No-Chicken/OV-Watch/3D Modle/按键零件.STL

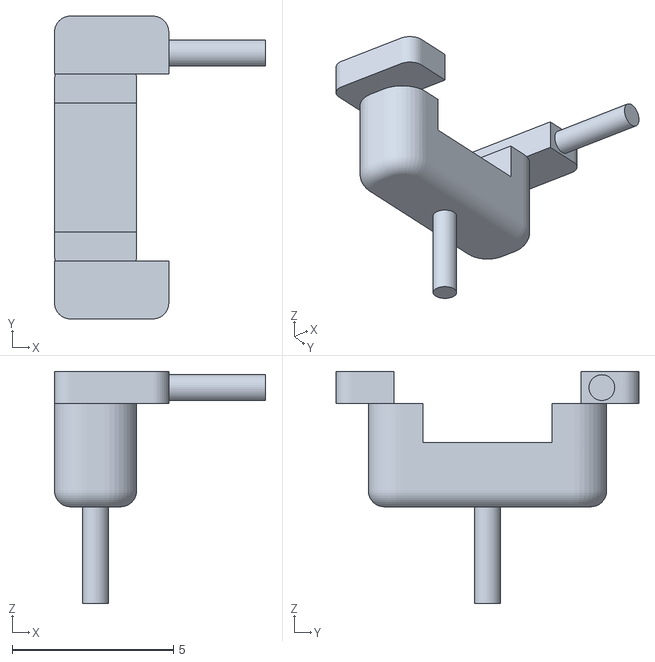
[picture p20: CAD file, 2023-07-12]
3D Modle/按键零件.STL
6.55 x 9.40 x 7.20
