No-Chicken/OV-Watch/3D Modle/后壳零件.STL

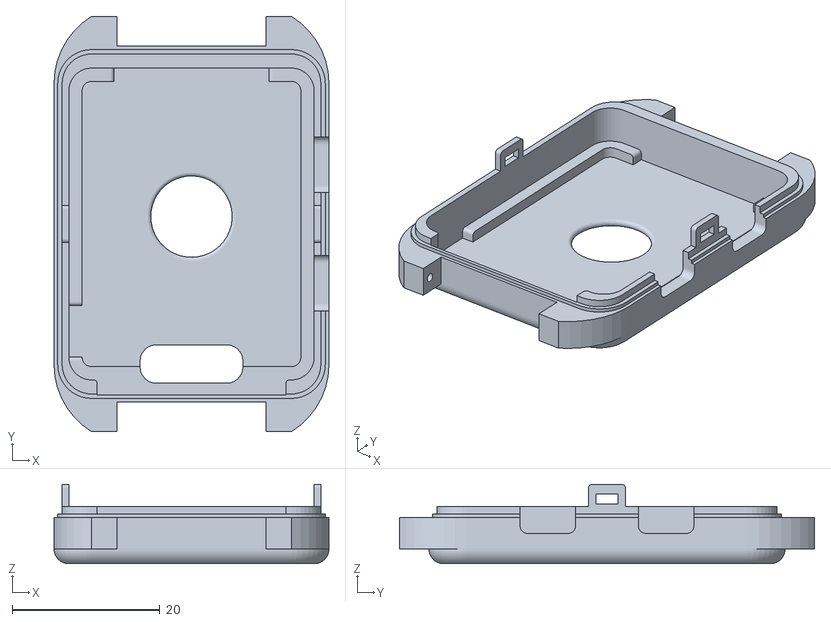
[picture p21: CAD file, 2023-07-12]
3D Modle/后壳零件.STL
37.2 x 56.2 x 10.8
