No-Chicken/OV-Watch/3D Modle/前壳零件.STL

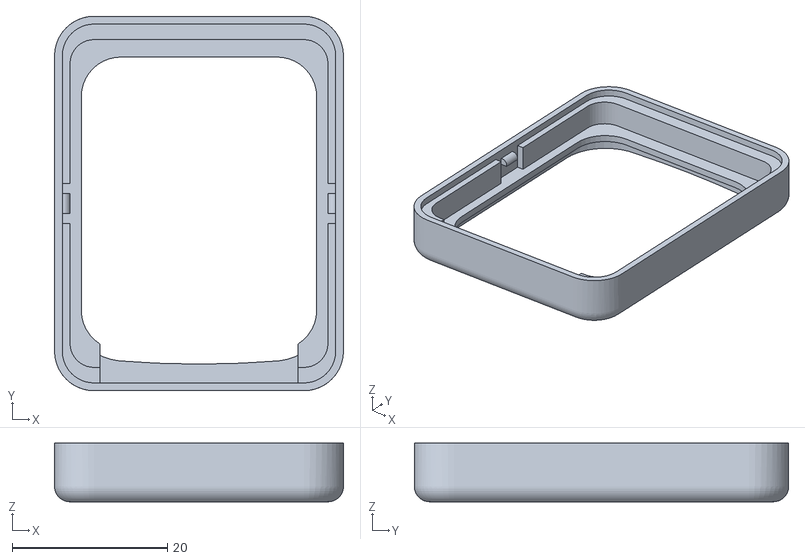
[picture p22: CAD file, 2023-07-12]
3D Modle/前壳零件.STL
37.2 x 48.2 x 7.55
