No-Chicken/OV-Watch/(threads)

Thread 5 (2024-06-12):

HelloGitHub 徽章计划

521xueweihan, 2024-06-12:
🎉 恭喜！您的[项目](https://hellogithub.com/repository/396acae90639497d82101e149577db8c)已被 HelloGitHub 社区收录和推荐，现邀请您加入 HelloGitHub 徽章计划。加入后，您将获得以下特权：

- 社区认可: 徽章代表你的项目已通过 HelloGitHub 社区的严格筛选，并获得推荐。
- 提高曝光: 佩戴徽章后，你的项目将获得更多推荐流量，吸引更多用户和贡献者。
- 增强互动: 用户可通过徽章快速了解项目，并与之互动（点赞、评论、收藏）。
- 收集反馈: 获取广大用户的真实反馈，持续优化你的项目。
- 特殊标识: 认证后，你的评论将有显著标识，并获得置顶优先权。

📌 [立即点击](https://hellogithub.com/repository/396acae90639497d82101e149577db8c/embed) 完成徽章佩戴，加入 HelloGitHub 徽章计划，让你的开源项目绽放更耀眼的光彩。

---

**HelloGitHub**，一个专注于发现、分享、推广开源项目的社区。自 2016 年创立以来，从每月一更的月刊发展到今天，已经成为一个拥有超过 **1 万** 用户的充满活力的开源社区。我们的足迹遍布多个内容平台，并获得了全网 **50 万** 粉丝的信赖与支持。

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

Closed 2025-01-04.

Thread 7 (2024-10-02):

IIC模块SDA引脚模式

JeffChong0125, 2024-10-02:
大佬，你这个IIC模块的SDA引脚的模式感觉还是配置为开漏输出模式好点，我看你代码这个模式切来切去的，不知道是不是我的理解不够深，正常应该是SCL和SDA直接配置为开漏输出，然后通过给0拉低，给1释放控制权，引脚直接由上拉电阻拉至高阻态

No-Chicken, 2025-01-04:
BSP驱动层可以不管了，能用就行

No-Chicken, 2025-01-04:
BSP驱动层可以不管了，能用就行

Closed 2025-01-04.

Thread 9 (2025-01-02):

Bug in DataSave.c

Lingxicheng, 2025-01-02:
如果使用这样的代码调用
```
uint8_t data[10] = {1,2,3};
EEPROM_Init();
SettingSave(data, 0x0, 10);
SettingGet(data, 0x0, 10);

```
data前两个值会发生改变，变成 0x55, 0xAA，最好将函数修改成这样
```
//to Save the settings
uint8_t SettingSave(uint8_t *buf, uint8_t addr, uint8_t lenth)
{
	if(addr > 1 &&!EEPROM_Check())
	{
		delay_ms(10);
		BL24C02_Write(addr,lenth,buf);
		return 0;
	}
	return 1;
}

//to Get the settings
uint8_t SettingGet(uint8_t *buf, uint8_t addr, uint8_t lenth)
{
	if(addr > 1 && !EEPROM_Check())
	{
		delay_ms(10);
		BL24C02_Read(addr,lenth,buf);
		return 0;
	}
	return 1;
}
```

No-Chicken, 2025-01-04:
是的，为了防止错误使用应该改成这样，可以pull request一下

Lingxicheng, 2025-01-05:
pull request 了,git 好复杂😉
