No-Chicken/OV-Watch/Hardware/SCH_Back_2024-05-26.pdf

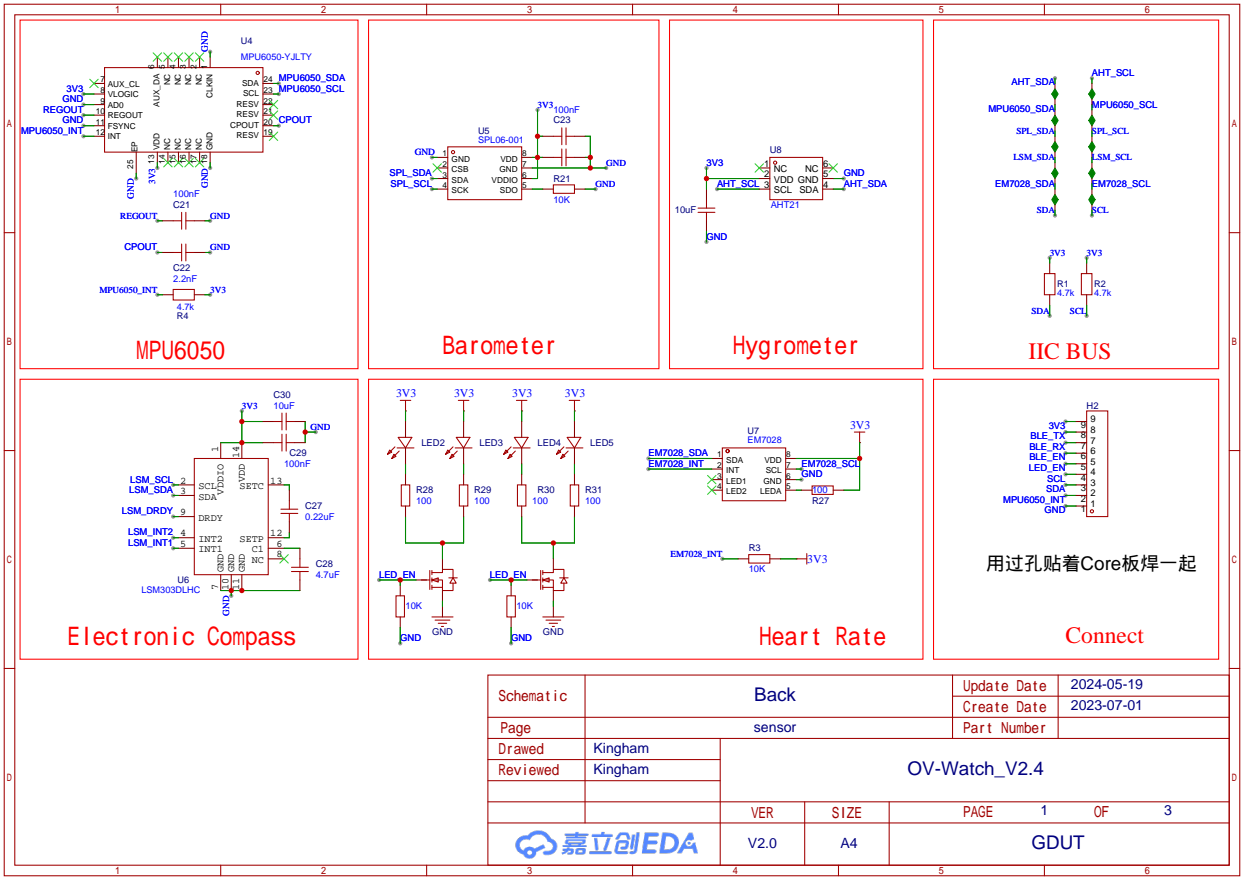
[picture p23: page 1]

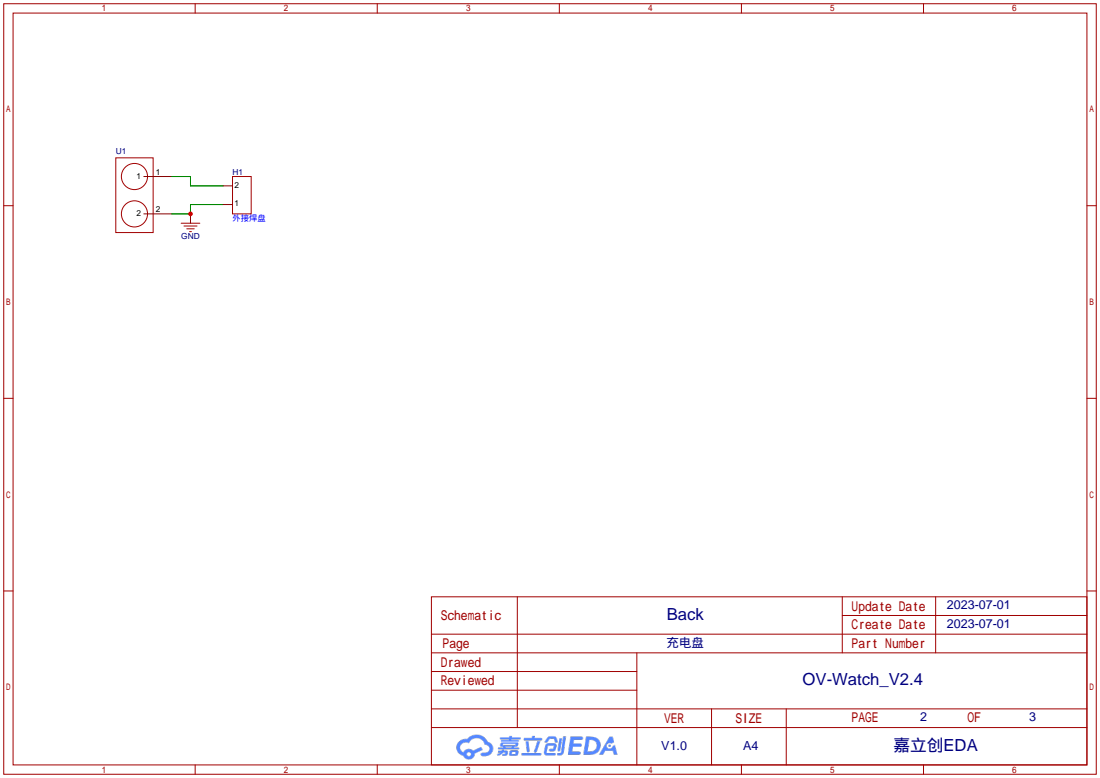
[picture p24: page 2]

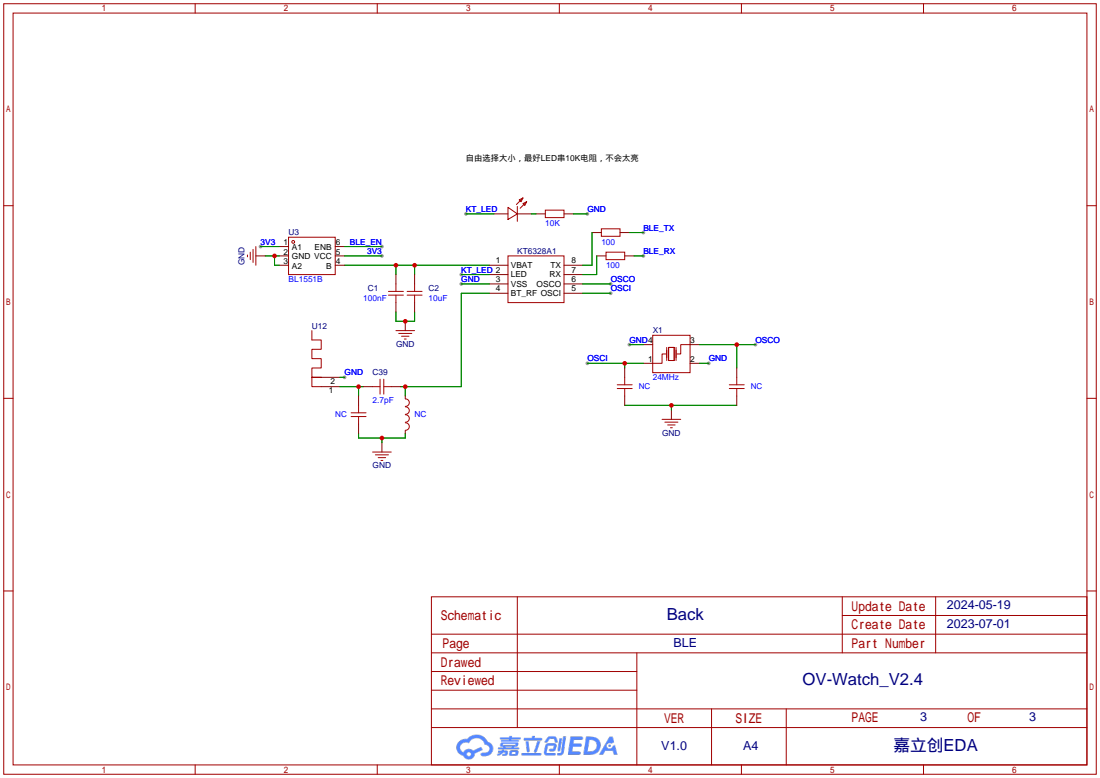
[picture p25: page 3]
