No-Chicken/OV-Watch/Hardware/SCH_Core_2024-05-26.pdf

# PA0 10 PA1 11 PA2 12 PA3 13 PA4 14 PA5 15 PA6 16 PA7 17

# PB1 19 PB2 20 PB3 39 PB4 40 PB5 41 PB6 42 PB7 43

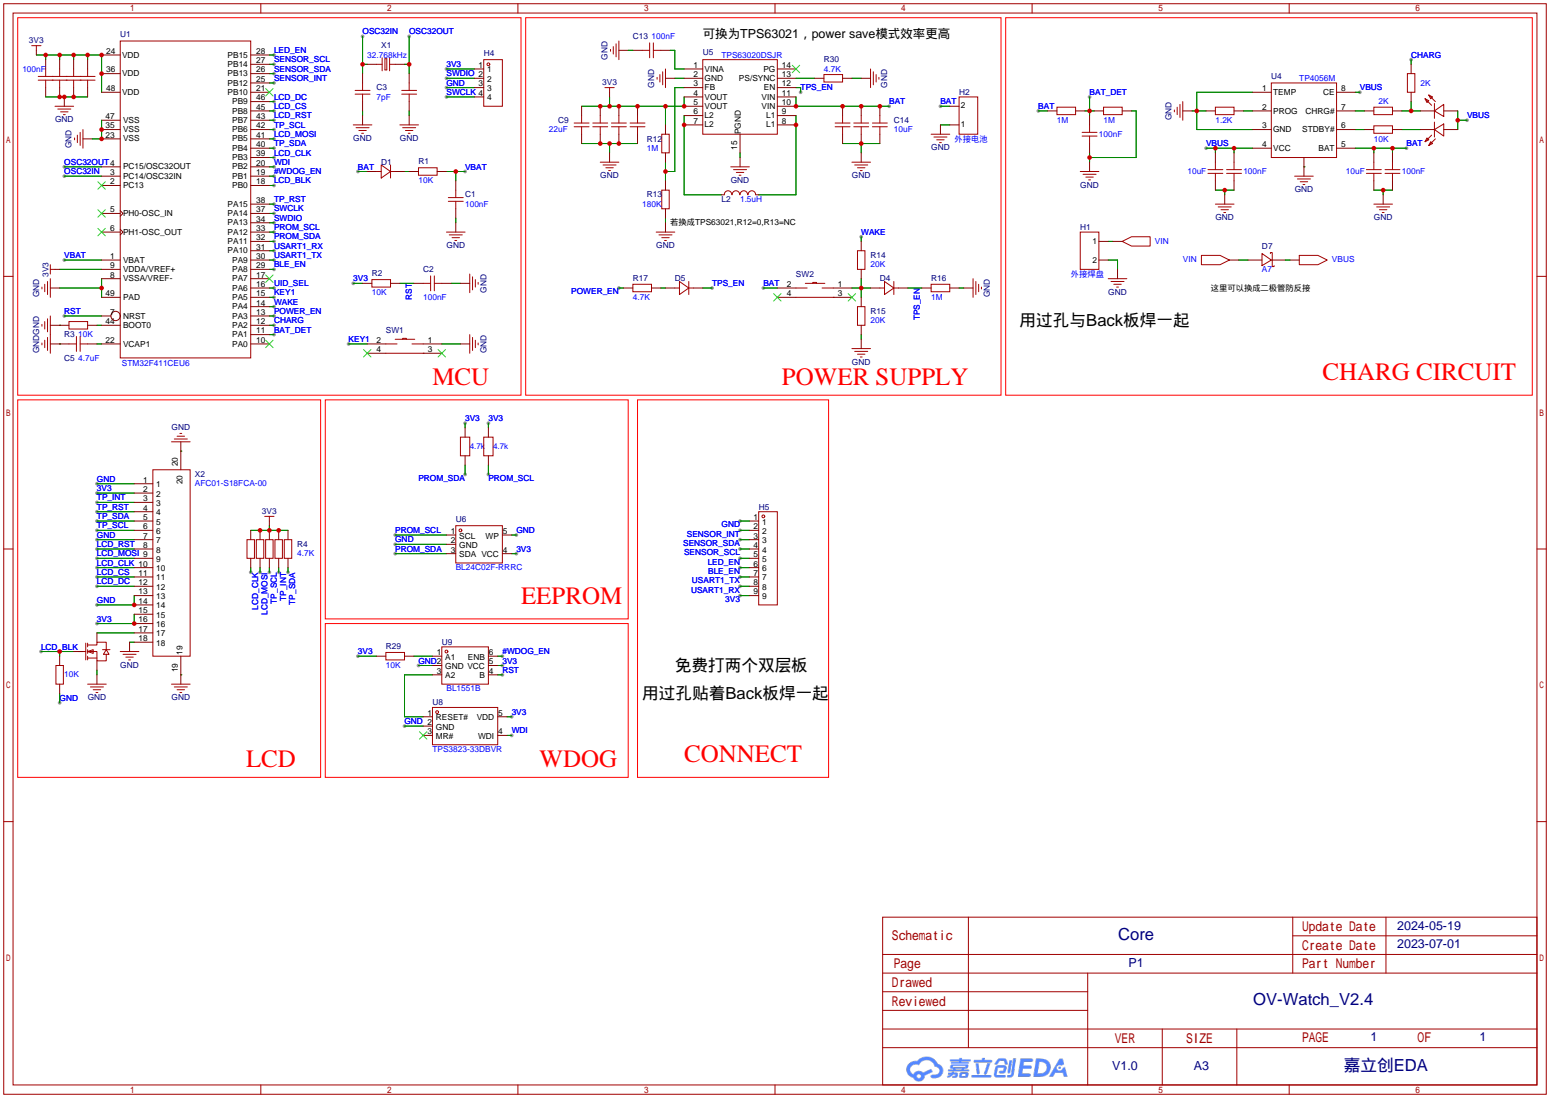
[picture p26: page 1]

VIN 10 VIN 11 EN 12 PS/SYNC 13 PG 14 PGND 15
