No-Chicken/OV-Watch/(list of files, drawings)

Other design files:
Hardware/OV-Watch_V2.4_LCProject_2024-05-25.epro
