No-Chicken/OV-Watch/Software/OV_Watch/OV_Watch.ioc

Mcu.UserName=STM32F411CEUx
PA1.Signal=ADCx_IN1
PA10.Signal=USART1_RX
PA13.Signal=SYS_JTMS-SWDIO
PA14.Signal=SYS_JTCK-SWCLK
PA9.Signal=USART1_TX
PB0.Signal=S_TIM3_CH3
PB3.Signal=SPI1_SCK
PB5.Signal=SPI1_MOSI
PC14-OSC32_IN.Signal=RCC_OSC32_IN
PC15-OSC32_OUT.Signal=RCC_OSC32_OUT
