No-Chicken/OV-Watch/Software/OV_Watch/BSP/KT6328/KT6328.h

#ifndef __KT6328_H__
#define __KT6328_H__

#ifdef __cplusplus
extern "C" {
#endif

#include "main.h"

void KT6328_GPIO_Init(void);
void KT6328_Enable(void);
void KT6328_Disable(void);


#ifdef __cplusplus
}
#endif
#endif
