No-Chicken/OV-Watch/Software/OV_Watch/User/Tasks/Src/user_MessageSendTask.c

/* Private includes -----------------------------------------------------------*/
//includes
#include "string.h"
#include "stdio.h"

#include "main.h"
#include "stm32f4xx_it.h"
#include "rtc.h"

#include "user_TasksInit.h"
#include "user_MessageSendTask.h"

#include "ui.h"
#include "ui_EnvPage.h"
#include "ui_HRPage.h"
#include "ui_SPO2Page.h"
#include "ui_HomePage.h"
#include "ui_DateTimeSetPage.h"

#include "HWDataAccess.h"
#include "version.h"

/* Private typedef -----------------------------------------------------------*/

/* Private define ------------------------------------------------------------*/

/* Private variables ---------------------------------------------------------*/
struct
{
	RTC_DateTypeDef nowdate;
	RTC_TimeTypeDef nowtime;
	int8_t humi;
	int8_t temp;
	uint8_t HR;
	uint8_t SPO2;
	uint16_t stepNum;
}BLEMessage;

struct
{
	RTC_DateTypeDef nowdate;
	RTC_TimeTypeDef nowtime;
}TimeSetMessage;

/* Private function prototypes -----------------------------------------------*/

void StrCMD_Get(uint8_t * str,uint8_t * cmd)
{
	uint8_t i=0;
  while(str[i]!='=')
  {
      cmd[i] = str[i];
      i++;
  }
}

//set time//OV+ST=20230629125555
uint8_t TimeFormat_Get(uint8_t * str)
{
	TimeSetMessage.nowdate.Year = (str[8]-'0')*10+str[9]-'0';
	TimeSetMessage.nowdate.Month = (str[10]-'0')*10+str[11]-'0';
	TimeSetMessage.nowdate.Date = (str[12]-'0')*10+str[13]-'0';
	TimeSetMessage.nowtime.Hours = (str[14]-'0')*10+str[15]-'0';
	TimeSetMessage.nowtime.Minutes = (str[16]-'0')*10+str[17]-'0';
	TimeSetMessage.nowtime.Seconds = (str[18]-'0')*10+str[19]-'0';
	if(TimeSetMessage.nowdate.Year>0 && TimeSetMessage.nowdate.Year<99
		&& TimeSetMessage.nowdate.Month>0 && TimeSetMessage.nowdate.Month<=12
		&& TimeSetMessage.nowdate.Date>0 && TimeSetMessage.nowdate.Date<=31
		&& TimeSetMessage.nowtime.Hours>=0 && TimeSetMessage.nowtime.Hours<=23
		&& TimeSetMessage.nowtime.Minutes>=0 && TimeSetMessage.nowtime.Minutes<=59
		&& TimeSetMessage.nowtime.Seconds>=0 && TimeSetMessage.nowtime.Seconds<=59)
	{
		RTC_SetDate(TimeSetMessage.nowdate.Year, TimeSetMessage.nowdate.Month,TimeSetMessage.nowdate.Date);
		RTC_SetTime(TimeSetMessage.nowtime.Hours,TimeSetMessage.nowtime.Minutes,TimeSetMessage.nowtime.Seconds);
		printf("TIMESETOK\r\n");
	}

}

/**
  * @brief  send the message via BLE, use uart
  * @param  argument: Not used
  * @retval None
  */
void MessageSendTask(void *argument)
{
	while(1)
	{
		uint32_t hardint_flags = osEventFlagsWait(HardIntEventHandle, HARDINT_EVENT_UART, osFlagsWaitAny, osWaitForever);
		if((hardint_flags & HARDINT_EVENT_UART) != 0U)
		{
			uint8_t IdleBreakstr = 0;
			osMessageQueuePut(IdleBreak_MessageQueue,&IdleBreakstr,NULL,1);
			printf("RecStr:%s\r\n",HardInt_receive_str);
			if(!strcmp(HardInt_receive_str,"OV"))
			{
				printf("OK\r\n");
			}
			else if(!strcmp(HardInt_receive_str,"OV+VERSION"))
			{
				printf("VERSION=V%d.%d.%d\r\n", VERSION_MAJOR, VERSION_MINOR, VERSION_PATCH);
			}
			else if(!strcmp(HardInt_receive_str,"OV+SEND"))
			{
				HAL_RTC_GetTime(&hrtc,&(BLEMessage.nowtime),RTC_FORMAT_BIN);
				HAL_RTC_GetDate(&hrtc,&BLEMessage.nowdate,RTC_FORMAT_BIN);
				BLEMessage.humi = HWInterface.AHT21.humidity;
				BLEMessage.temp = HWInterface.AHT21.temperature;
				BLEMessage.HR = HWInterface.HR_meter.HrRate;
				BLEMessage.SPO2 = HWInterface.HR_meter.SPO2;
				BLEMessage.stepNum = HWInterface.IMU.Steps;

				printf("data:%2d-%02d\r\n",BLEMessage.nowdate.Month,BLEMessage.nowdate.Date);
				printf("time:%02d:%02d:%02d\r\n",BLEMessage.nowtime.Hours,BLEMessage.nowtime.Minutes,BLEMessage.nowtime.Seconds);
				printf("humidity:%d%%\r\n",BLEMessage.humi);
				printf("temperature:%d\r\n",BLEMessage.temp);
				printf("Heart Rate:%d%%\r\n",BLEMessage.HR);
				printf("SPO2:%d%%\r\n",BLEMessage.SPO2);
				printf("Step today:%d\r\n",BLEMessage.stepNum);
			}
			//set time//OV+ST=20230629125555
			else if(strlen(HardInt_receive_str)==20)
			{
				uint8_t cmd[10];
				memset(cmd,0,sizeof(cmd));
				StrCMD_Get(HardInt_receive_str,cmd);
				if(ui_APPSy_EN && !strcmp(cmd,"OV+ST"))
				{
					TimeFormat_Get(HardInt_receive_str);
				}
			}
			memset(HardInt_receive_str,0,sizeof(HardInt_receive_str));
		}
	}
}
