No-Chicken/OV-Watch/Software/OV_Watch/Core/Src/rtc.c

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
/* Includes ------------------------------------------------------------------*/
#include "rtc.h"

RTC_HandleTypeDef hrtc;

/* RTC init function */
void MX_RTC_Init(void)
{

  RTC_TimeTypeDef sTime = {0};
  RTC_DateTypeDef sDate = {0};

  /** Initialize RTC Only
  */
  hrtc.Instance = RTC;
  hrtc.Init.HourFormat = RTC_HOURFORMAT_24;
  hrtc.Init.AsynchPrediv = 127;
  hrtc.Init.SynchPrediv = 255;
  hrtc.Init.OutPut = RTC_OUTPUT_DISABLE;
  hrtc.Init.OutPutPolarity = RTC_OUTPUT_POLARITY_HIGH;
  hrtc.Init.OutPutType = RTC_OUTPUT_TYPE_OPENDRAIN;
  if (HAL_RTC_Init(&hrtc) != HAL_OK)
  {
    Error_Handler();
  }

  /* USER CODE BEGIN Check_RTC_BKUP */
	if(HAL_RTCEx_BKUPRead(&hrtc,RTC_BKP_DR0)!=0X5050)//是否第一次配置
  {
  /* USER CODE END Check_RTC_BKUP */

  /** Initialize RTC and set the Time and Date
  */
  sTime.Hours = 0x11;
  sTime.Minutes = 0x59;
  sTime.Seconds = 0x55;
  sTime.DayLightSaving = RTC_DAYLIGHTSAVING_NONE;
  sTime.StoreOperation = RTC_STOREOPERATION_RESET;
  if (HAL_RTC_SetTime(&hrtc, &sTime, RTC_FORMAT_BCD) != HAL_OK)
  {
    Error_Handler();
  }
  sDate.WeekDay = RTC_WEEKDAY_SUNDAY;
  sDate.Month = RTC_MONTH_MAY;
  sDate.Date = 0x21;
  sDate.Year = 0x23;

  if (HAL_RTC_SetDate(&hrtc, &sDate, RTC_FORMAT_BCD) != HAL_OK)
  {
    Error_Handler();
  }

  /** Enable the WakeUp
  */
  if (HAL_RTCEx_SetWakeUpTimer_IT(&hrtc, 2000, RTC_WAKEUPCLOCK_RTCCLK_DIV16) != HAL_OK)
  {
    Error_Handler();
  }
  /* USER CODE BEGIN RTC_Init 2 */
	HAL_RTCEx_BKUPWrite(&hrtc,RTC_BKP_DR0,0X5050);//标记已经初始化过了
  }
  /* USER CODE END RTC_Init 2 */

}

void HAL_RTC_MspInit(RTC_HandleTypeDef* rtcHandle)
{

  RCC_PeriphCLKInitTypeDef PeriphClkInitStruct = {0};
  if(rtcHandle->Instance==RTC)
  {
  /** Initializes the peripherals clock
  */
    PeriphClkInitStruct.PeriphClockSelection = RCC_PERIPHCLK_RTC;
    PeriphClkInitStruct.RTCClockSelection = RCC_RTCCLKSOURCE_LSE;
    if (HAL_RCCEx_PeriphCLKConfig(&PeriphClkInitStruct) != HAL_OK)
    {
      Error_Handler();
    }

    /* RTC clock enable */
    __HAL_RCC_RTC_ENABLE();

    /* RTC interrupt Init */
    HAL_NVIC_SetPriority(RTC_WKUP_IRQn, 5, 0);
    HAL_NVIC_EnableIRQ(RTC_WKUP_IRQn);
  }
}

void HAL_RTC_MspDeInit(RTC_HandleTypeDef* rtcHandle)
{

  if(rtcHandle->Instance==RTC)
  {
    /* Peripheral clock disable */
    __HAL_RCC_RTC_DISABLE();

    /* RTC interrupt Deinit */
    HAL_NVIC_DisableIRQ(RTC_WKUP_IRQn);
  }
}

/* USER CODE BEGIN 1 */
uint8_t weekday_calculate(int y,int m,int d,int c)
{
	int w;
	if (m == 1 || m == 2)
	{y--, m += 12;}
	w = y + y / 4 + c / 4  + 26*(m + 1)/10 + d - 1 - 2 * c;
	while(w<0)
		w+=7;
	w%=7;
	w=(w==0)?7:w;
	return w;
}

void RTC_SetTime(uint8_t hours, uint8_t minutes, uint8_t seconds)
{
	RTC_TimeTypeDef time={0};//不设置为{0}时间就会离谱
	time.Hours=hours;
	time.Minutes=minutes;
	time.Seconds=seconds;
	if (HAL_RTC_SetTime(&hrtc, &time, RTC_FORMAT_BIN) != HAL_OK)
  {
    Error_Handler();
  }
}

void RTC_SetDate(uint8_t year, uint8_t month, uint8_t date)
{
	RTC_DateTypeDef setdate={0};//不设置为{0}时间就会离谱
	setdate.Date=date;
	setdate.Month=month;
	setdate.Year=year;

	//culculat the weekday
	setdate.WeekDay = weekday_calculate(year,month,date,20);

	if (HAL_RTC_SetDate(&hrtc, &setdate, RTC_FORMAT_BIN) != HAL_OK)
  {
    Error_Handler();
  }
}
/* USER CODE END 1 */
