No-Chicken/OV-Watch/Software/OV_Watch/User/Tasks/Inc/user_ScrRenewTask.h

#ifndef __USER_SCRRENEWTASK_H__
#define __USER_SCRRENEWTASK_H__

#ifdef __cplusplus
extern "C" {
#endif

#include "PageManager.h"

void ScrRenewTask(void *argument);


#ifdef __cplusplus
}
#endif

#endif
