No-Chicken/OV-Watch/Software/OV_Watch/User/Tasks/Inc/user_DataSaveTask.h

#ifndef __USER_DATASAVETASK_H__
#define __USER_DATASAVETASK_H__

#ifdef __cplusplus
extern "C" {
#endif

#include "user_TasksInit.h"


void DataSaveTask(void *argument);

	
#ifdef __cplusplus
}
#endif

#endif
