No-Chicken/OV-Watch/Software/OV_Watch/BSP/EM7028/user_Queue.h

#include <stdio.h>
#include <stdbool.h>
#include <stdlib.h>
#include "main.h"

// 定义队列结构
#define QUEUE_SIZE 7

typedef struct {
    int8_t front;
    int8_t rear;
    int8_t size;
    uint32_t data[QUEUE_SIZE];
} Queue;

void initQueue(Queue *queue);
bool isQueueEmpty(Queue *queue);
bool isQueueFull(Queue *queue);
void enqueue(Queue *queue, unsigned long item);
uint32_t dequeue(Queue *queue);
