No-Chicken/OV-Watch/(commit log)

2023-07-12 currect the iic bus
    currect the EEPROM(BL24C02)'s SDA&SCL pin in /Hardware/BL24C02/BL24C02.c
2023-07-12 Uploat V2.3
    [上壳零件.STL, 下壳零件.STL, 前壳零件.STL, 后壳零件.STL, 按键.STL, 按键零件.STL]
2023-07-12 Upload V2.3
    [上壳零件.STL, 下壳零件.STL, 前壳零件.STL, 后壳零件.STL, 按键.STL, 按键零件.STL]
2023-07-14 Change some name of thread and MQ
2023-07-14 Fix a bug in memGame
    fix a bug that popping out the replay logo when the game is not finish, that's due to the 'x' para in the 'for' loop is not initialized, the function Game_Mem_Finish() will randomly return wrong value.
2023-07-17 Set Power Save mode
    change the hardware part, tps63020 set to power save mode, the PS/SYNC set to 0
2023-07-26 ver2.3.2, fix some bugs
    function add:
    1. mpu6050 get the steps in the low power mode
    2. EEPROM save the date and system settings
    fixed bugs:
    1.randomly reset after wake up
    2.use the dmp lib, the memgame will chock
    [AHT21.c, AHT21.h, CST816.c, CST816.h]
2023-07-26 Hardware change(power save)
    Change the power part, set TPS63020 to power save mode, which means the PS/SYNC port set to 0. The efficiency is almost 90% in power save enabled mode, but almost 60% in power save disabled mode.
2023-07-28 Fix some bugs
    1. fixed the bug that the system would always be wake when charging.
    2. change the threshold in func MPU_isHorizontal
    [mpu6050.c]
2023-08-11 fixed a type erro
    [mpu6050.c]
2023-08-12 upload firmware & fix some annotation
    [mpu6050.c]
2023-08-16 fixed a bug in AHT21 reading
    [AHT21.c]
2024-03-12 fix AHT21 BSP bug
    [AHT21.c]
2024-05-26 update ver 2.4.0 , fixed the hardware BLE bug
    [OV-Watch_V2.4_LCProject_2024-05-25.epro]
2024-06-02 更新了LVGL在vscode仿真，在SDL.c中加入了键盘backspace键按键触发屏幕切换，添加了消息订阅框架：键盘回车键按下发布按键消息，UI.c中subscriber函数收到消息后，执行界面切换
2024-06-04 轻微更改代码的结构，将功能函数单独放一个工程文件夹
2024-06-05 软件修复2.4版本的功耗问题，串口在睡眠时DeInit, 让串联电阻不耗电
2024-06-05 修改串口回复的版本信息
2024-06-05 在BootLoader中加入长按KEY1关机
2024-06-05 修改按键KEY的驱动，按下按键后松开才生效
2024-06-05 APP加入长按KEY1关机功能
2024-06-05 上传V2.4.1固件
2024-06-05 修改APP开机启动信息
2024-06-05 更新2.4.1
2024-06-05 更改一些描述
2024-06-24 更换文件夹名, 以后OV-Watch的APP都没有版本号, 仅在version.h中展现
2024-06-24 1.更改代码框架, 2. 加入version.h记录信息, 3.加入中间层用于UI层访问BSP层和HAL层，暂时写了RTC
2024-06-25 加入HWDataAccess.c作为中间层, 用于UI层访问BSP层和HAL库
    这样方便移植，直接将User中的Func和GUI_App复制到vscode仿真工程中就行了。或者在仿真器中跑好了UI，也方便直接复制过去keil工程
2024-06-25 更新LVGL在Vscode的仿真工程
2024-07-01 加入PageManager, 更新新的界面管理框架
2024-07-01 新的页面管理框架同步更新到LVGL Vscode仿真
2024-07-02 使能HW_USE_HARDWARE
2024-07-28 完善最新框架
    在ui层，访问硬件通义通过HWDataAccess.c
2024-07-28 更新最新框架的LVGL Vscode仿真
2024-07-28 更新工程设置
2024-07-28 更新固件
2024-07-28 删除main.c中多余include
2024-07-29 上传说明手册链接
2024-07-31 更改IMU初始化bug
2024-10-16 上传不需要boot的hex固件
    直接在STM32 ST-LINK Utility下载即可
2025-06-02 update BLE hardware interface
    加入init 在初始化中使用这个接口而不直接使用BSP的接口
2025-10-19 FIX BUG 解决linux平台下编译 lv_sim_vscode_vin项目编译类型报错问题
2026-05-02 更改屏幕驱动
2026-05-02 优化定时器页面时基
2026-05-02 将LCD改为异步刷新，不阻塞，加快速度
2026-05-02 更新版本
2026-05-03 更新LV刷新时间
2026-05-03 更新图片
2026-05-03 更新地址
2026-05-03 更新设置
2026-05-04 更新空闲管理
2026-05-04 修复中断设置bug
2026-05-04 使用事件标志
