No-Chicken/OV-Watch/(notices)

Notices in the files:
Software/OV_Watch/Core/Src/rtc.c:
Copyright (c) 2023 STMicroelectronics.
All rights reserved.
This software is licensed under terms that can be found in the LICENSE file
Software/OV_Watch/BSP/MPU6050/eMPL/inv_mpu.c:
Copyright(C) ¹ãÖÝÊÐÐÇÒíµç×Ó¿Æ¼¼ÓÐÏÞ¹«Ë¾ 2009-2019
README.md:
License: GPL3.0
